b-z-l/Bottle-Sensor/README.md

# User Assembled Particlate Matter Sensor

Here lies supporting files for an air quality sensor based around the Shinyei PPD42 dust sensor.
