b-z-l/Bottle-Sensor/docs/images/mount_adapter.jpg

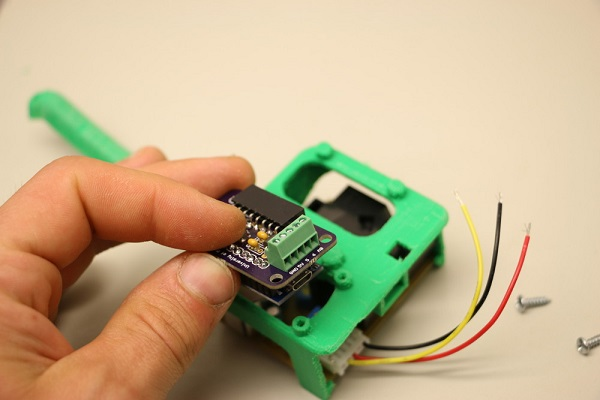
docs/images/mount_adapter.jpg
