b-z-l/Bottle-Sensor/docs/images/sensor_cables.JPG

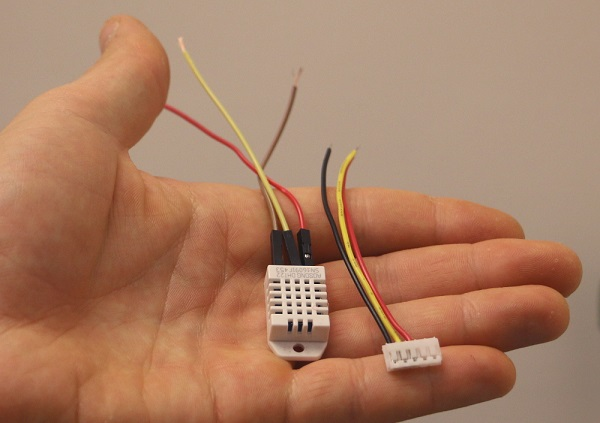
docs/images/sensor_cables.JPG
