b-z-l/Bottle-Sensor/(commit log)

2017-07-07 Update SOP.md
    BOM initial table
2017-07-08 Fixing BOM table
2017-07-08 Update SOP.md
    BOM Links
